iamtheeel/MyoHID/README.md

# MyoHID
Myoelectric Control of a Human Interface Device

Video of System in Action

<p align="center">
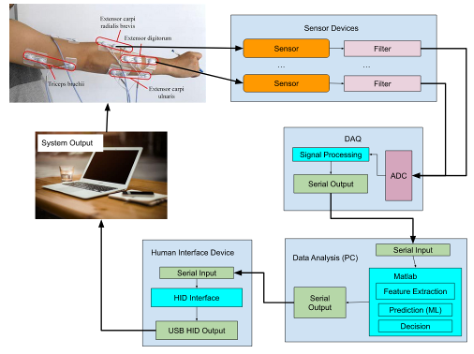
[picture p1: images/blockDiagram.png]
Block Diagram
  
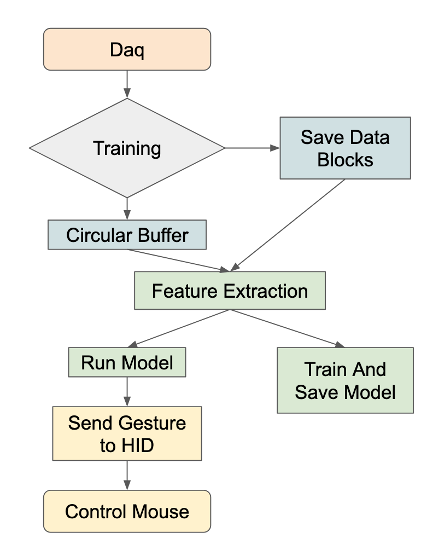
[picture p2: images/flowChart.png]
Flow Chart
  

</p>

The default method of interfacing with computational equipment is the keyboard and mouse. These inputs can be challenging for people with even mild disabilities. If not used correctly, improper use can lead to nerve damage causing disability. 
We have captured electromyography data with low cost off the shelf hardware, processed the signals with the help of a machine learning algorithm, and then used that processed information to control a human interface device to operate a mouse for any common computer system.

The software is broken into three major categories. In either MATLAB, or C++ under Arduino
*	Data Acquisition (DAQ)
    -	arduinoDAQ.ino
    -	serialComms.cpp
    - serialComms.h
*	Signal Processing (MATLAB)
    -	The entry point
        - frontEnd.mlx
    -	Record data for analysis and training
        - recordDataBlocks.m
        - blockExtract.m
    -	Run Realtime capture of data from the DAQ, process data, and send to the HID
        - realTime.m
    -	Serial packets receive and parse, Circular buffer for Realtime
        - dataHandeler.m
    -	Feature Extraction
        - dataProc.m
        - calcFFT.m
    -	Data Analisis tools
        - plotFeatures.m
*	Human Interface Device (HID)
    -	HID.ino
    -	gestureMap.h
    -	serialComms.cpp
    -	serialComms.h

The hardware List:
|System		|Component	|Vendor	|Part|
|---|---|---|---|
|Sensor |Instrunemtaion Amplifier |Advancer Tech. |Muscle Sensor Platinum V3|
|Sensor |Self Adhesive Electrodes |Corvidian |H124SG |
|Amplifier|Dual Channel Low Power Op Amp|Texas Instruments|TI6002 |
|Filter |Ceramic Capacitors (10%) |1A Manufacturing |EE916A |
|Filter |Metal Film Resistors (1%) |Bojack |BJ-50 |
|DAQ |Microcontroller |Arduino |UNO R4 |
|HID |Microcontroller |Adafruit |QT Py M0 |
